FutureSharks/e-paper-art-display/artwork/003_jan-van-eyck_portrait-of-a-man-self-portrait.jpg

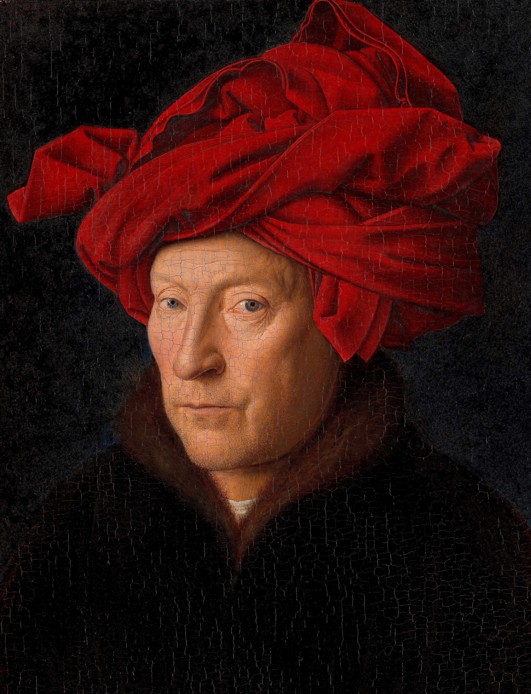
artwork/003_jan-van-eyck_portrait-of-a-man-self-portrait.jpg
