FutureSharks/e-paper-art-display/artwork/003_jan-van-eyck_portrait-of-a-man-self-portrait.preview.png

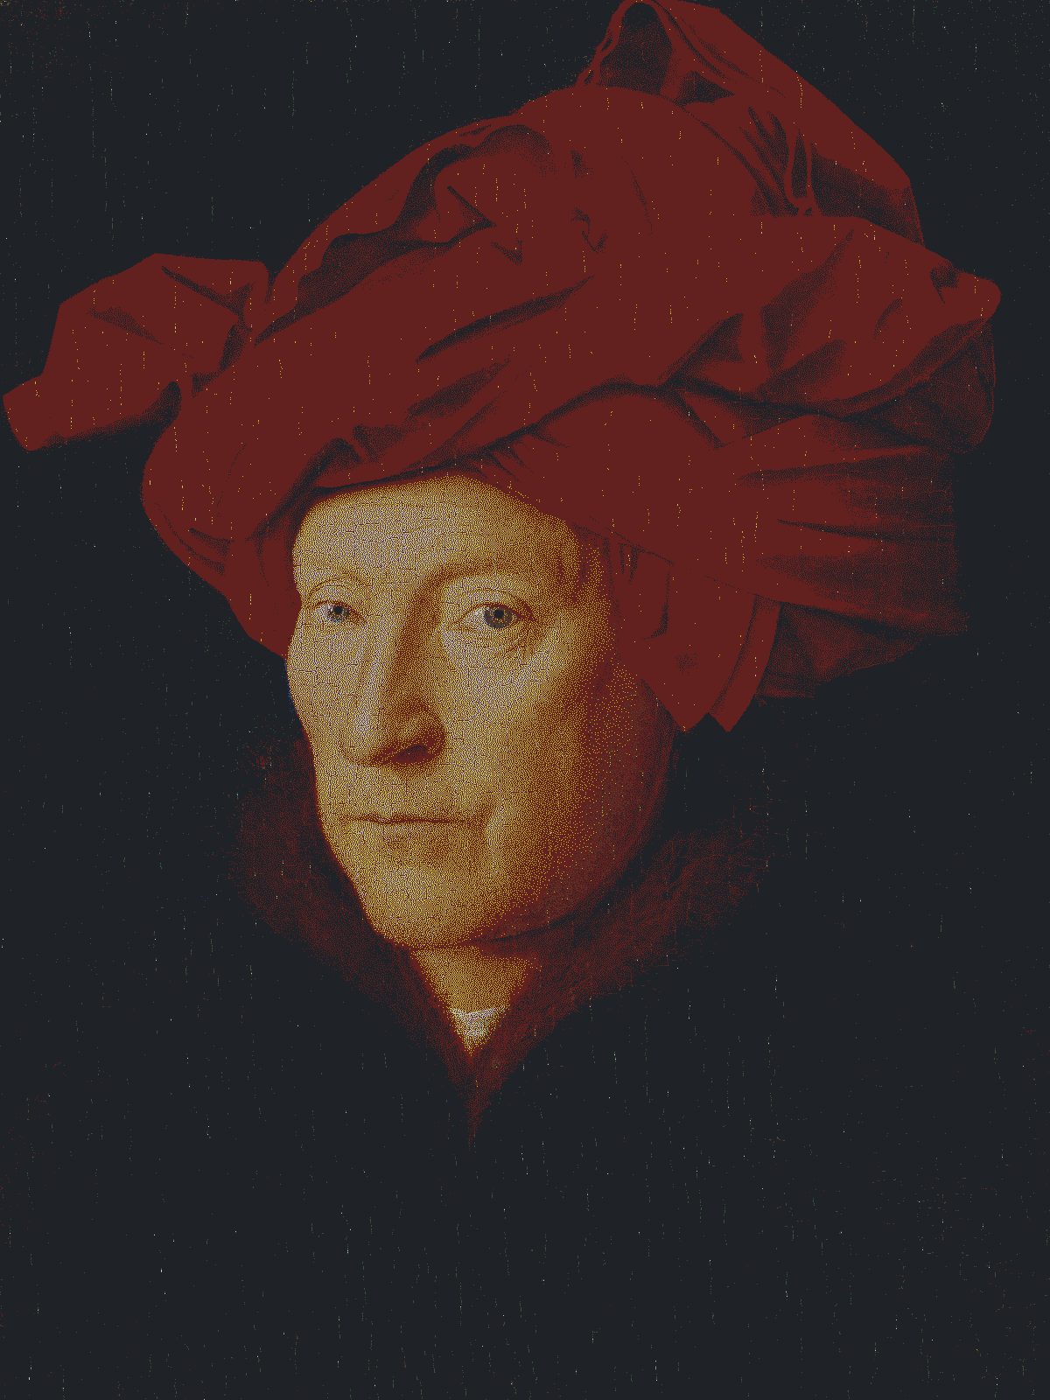
artwork/003_jan-van-eyck_portrait-of-a-man-self-portrait.preview.png
