FutureSharks/e-paper-art-display/artwork/004_johannes-vermeer_girl-with-a-pearl-earring.jpg

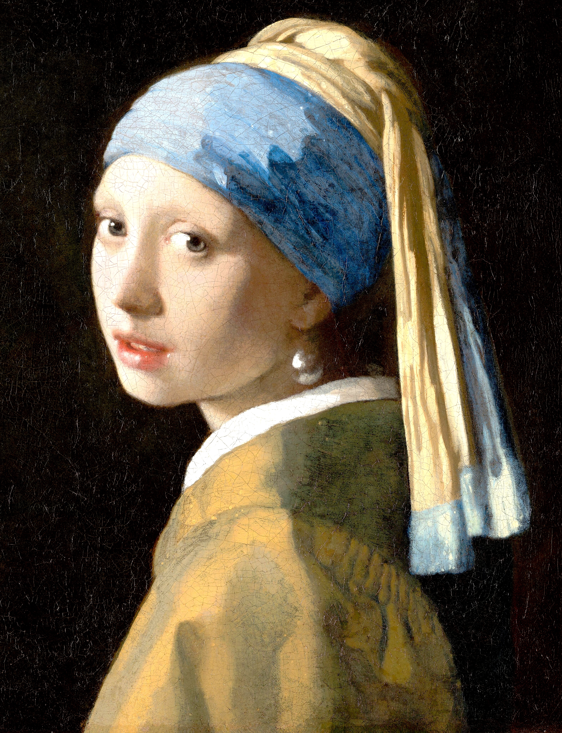
artwork/004_johannes-vermeer_girl-with-a-pearl-earring.jpg
