FutureSharks/e-paper-art-display/artwork/009_sandro-botticelli_idealized-portrait-of-a-lady-portrait-of-simonetta.preview.png

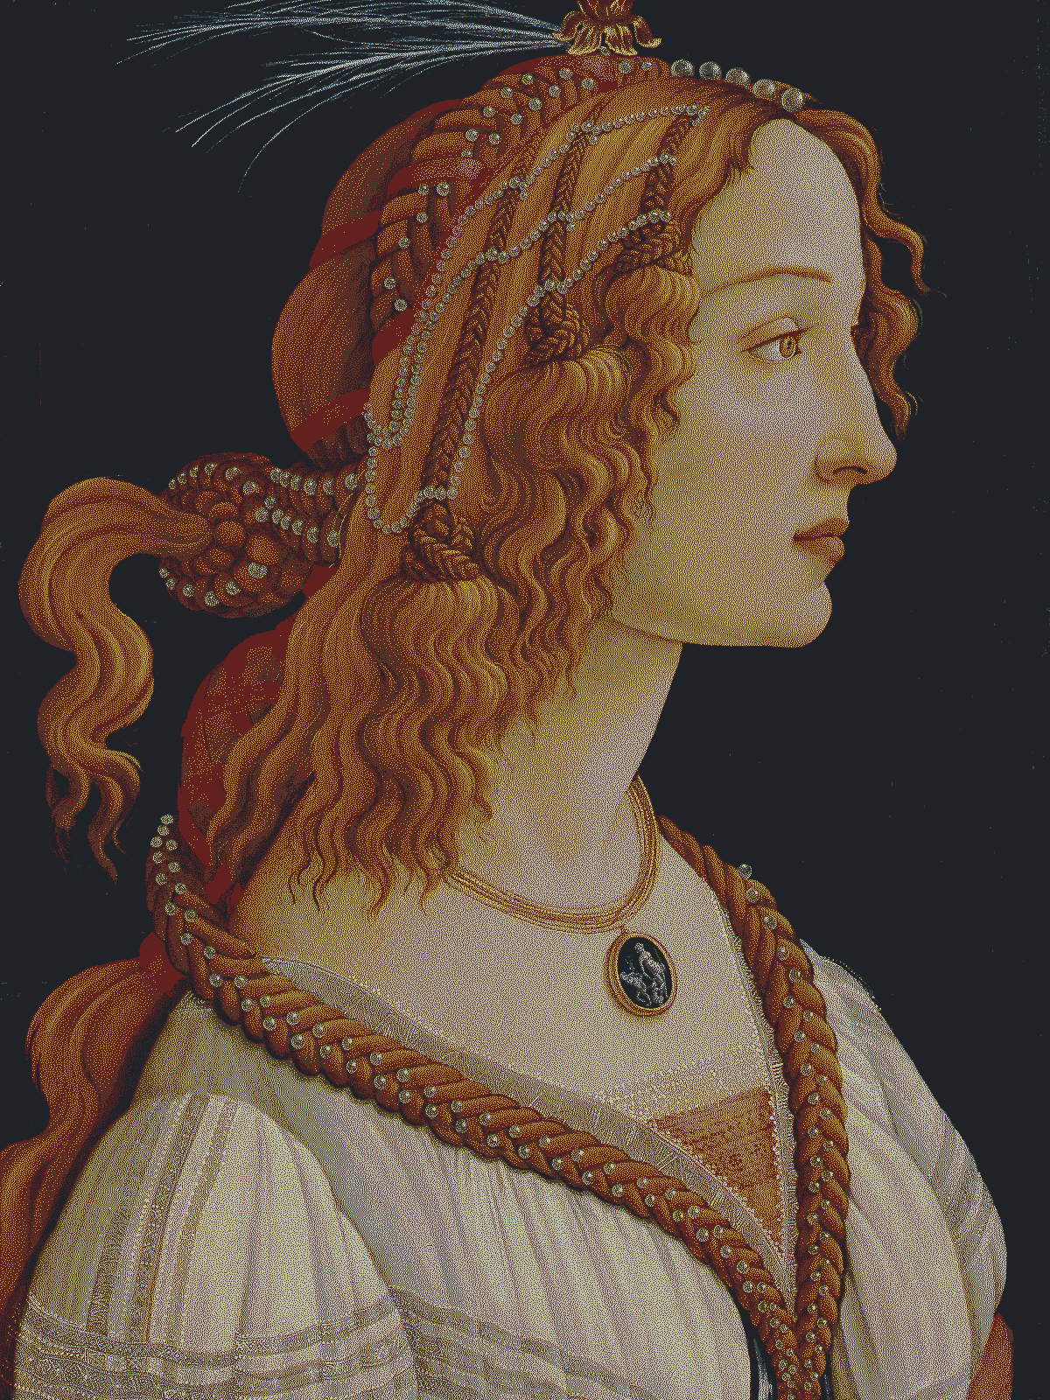
artwork/009_sandro-botticelli_idealized-portrait-of-a-lady-portrait-of-simonetta.preview.png
