FutureSharks/e-paper-art-display/artwork/013_alexej-von-jawlensky_lady-with-fan.jpg

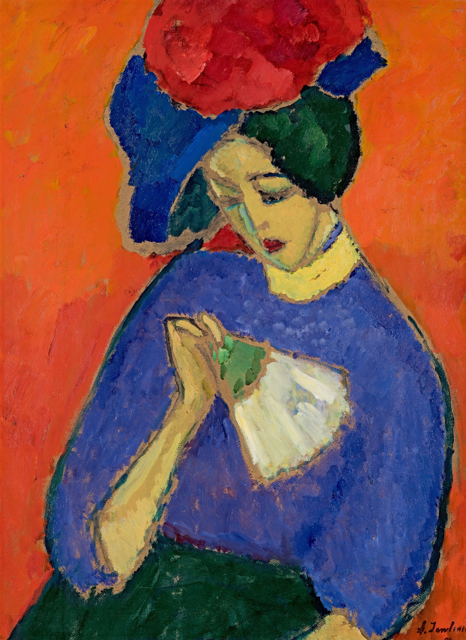
artwork/013_alexej-von-jawlensky_lady-with-fan.jpg
