FutureSharks/e-paper-art-display/artwork/013_alexej-von-jawlensky_lady-with-fan.preview.png

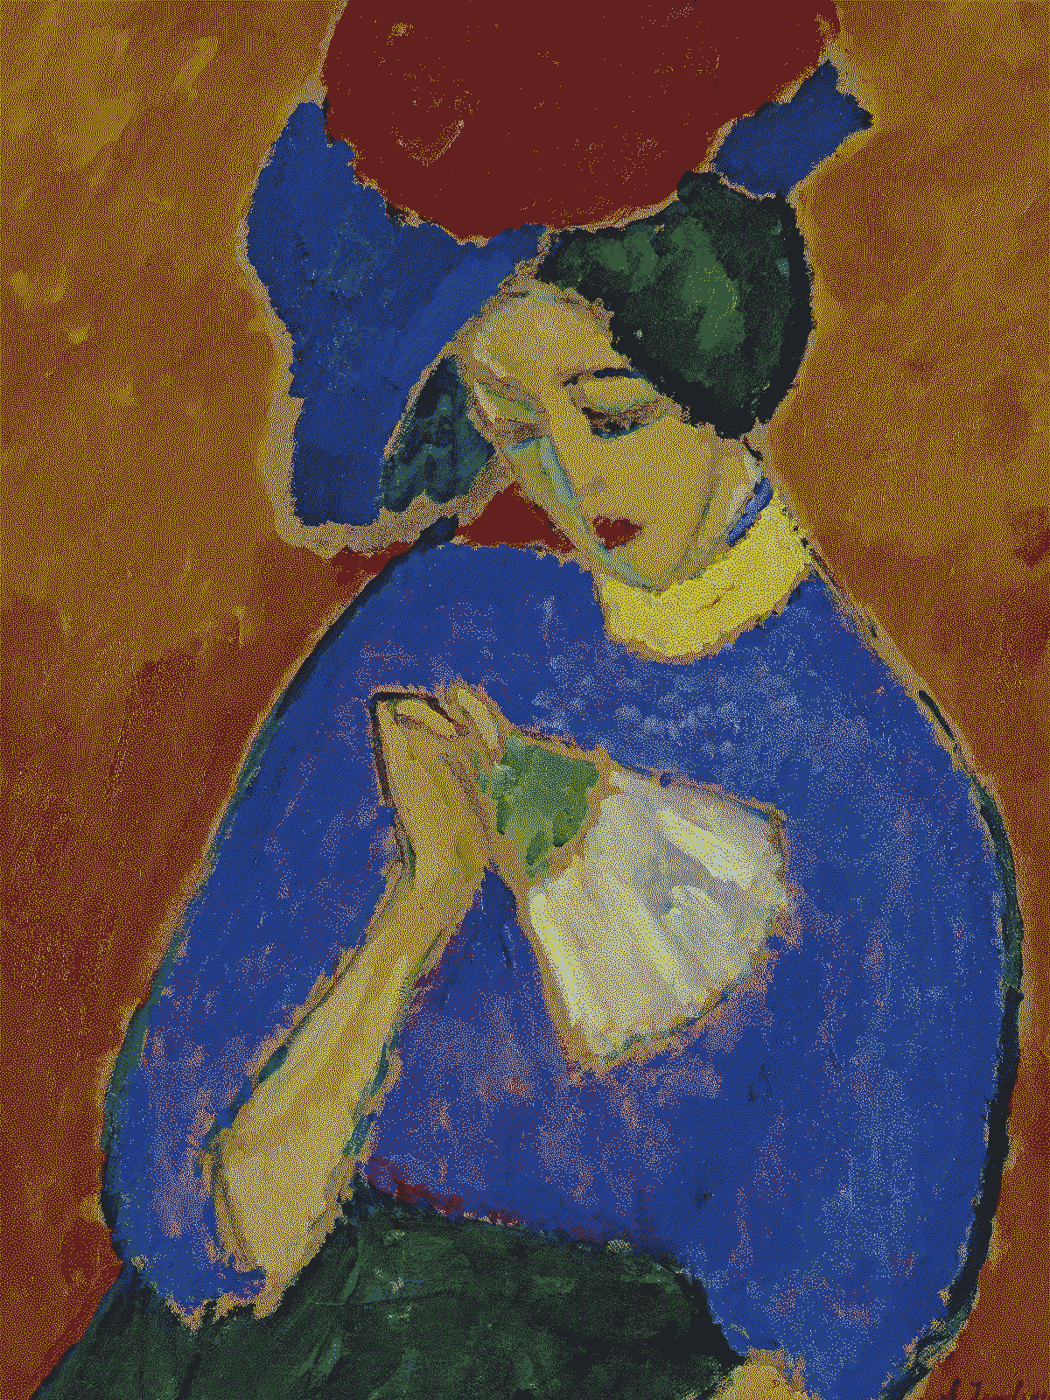
artwork/013_alexej-von-jawlensky_lady-with-fan.preview.png
