FutureSharks/e-paper-art-display/artwork/034_august-macke_woman-supporting-a-flower-bowl.jpg

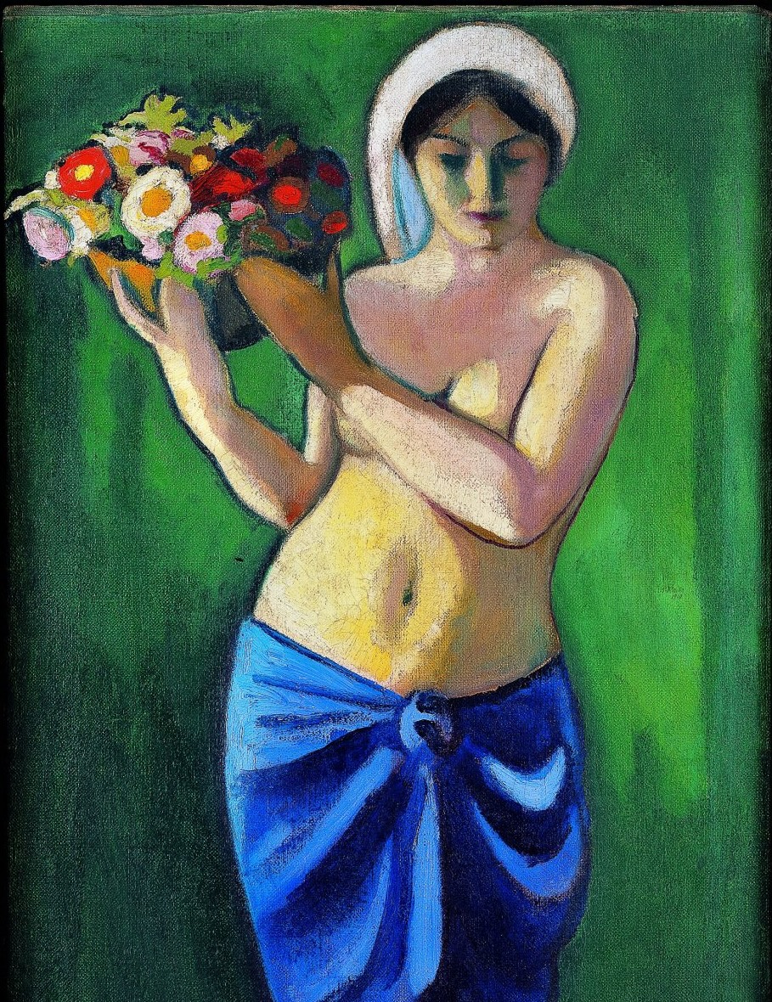
artwork/034_august-macke_woman-supporting-a-flower-bowl.jpg
