FutureSharks/e-paper-art-display/artwork/034_august-macke_woman-supporting-a-flower-bowl.preview.png

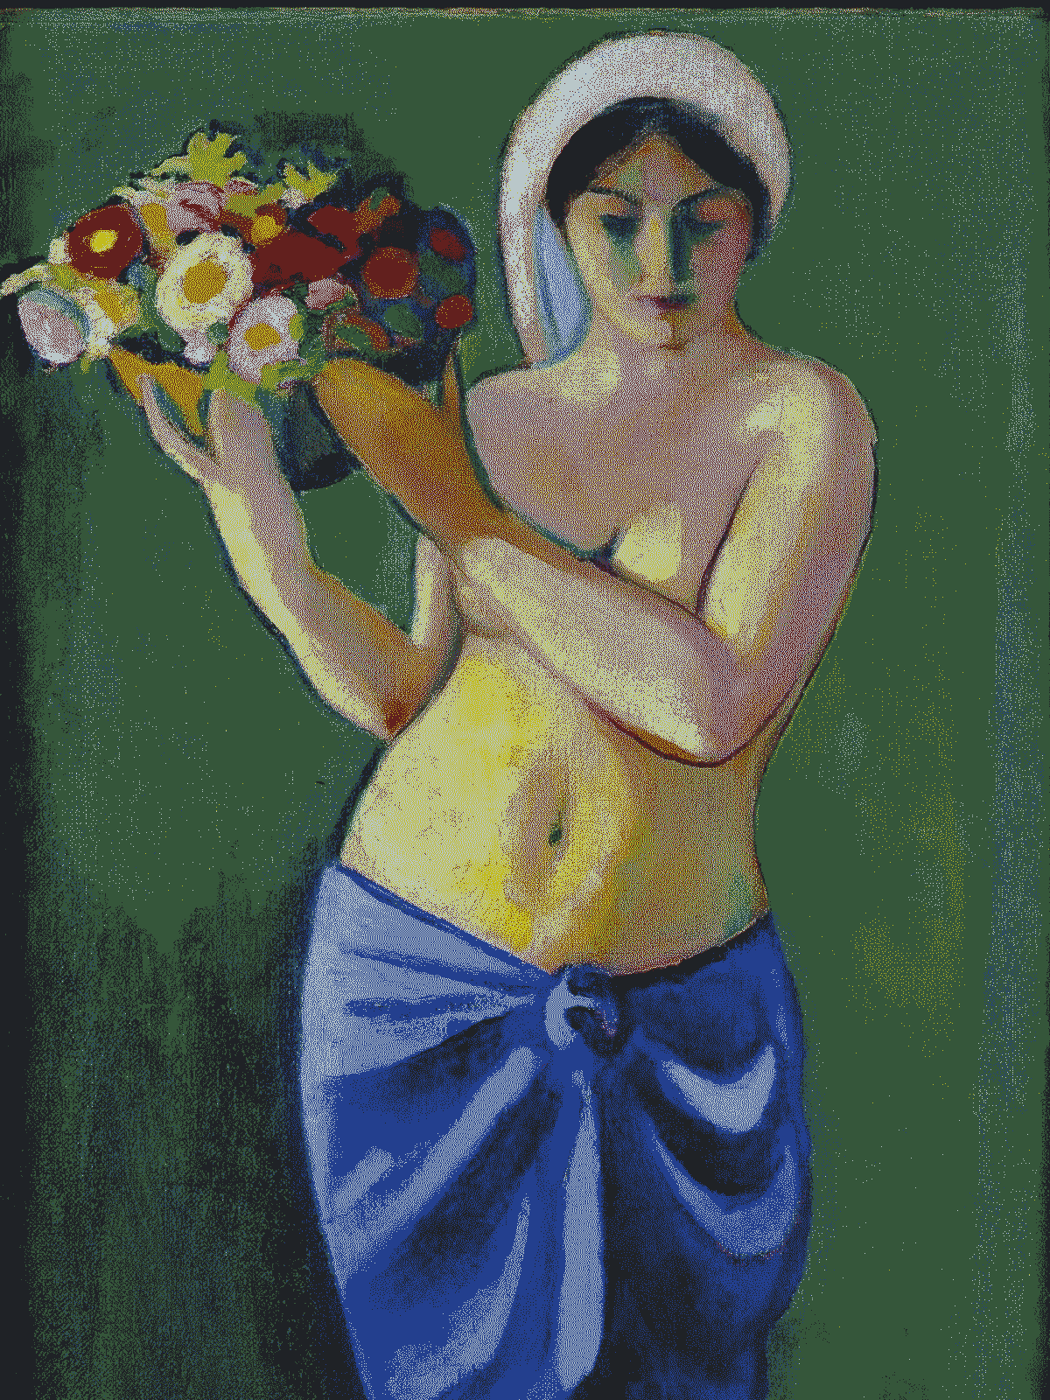
artwork/034_august-macke_woman-supporting-a-flower-bowl.preview.png
