FutureSharks/e-paper-art-display/artwork/036_edvard-munch_the-scream.jpg

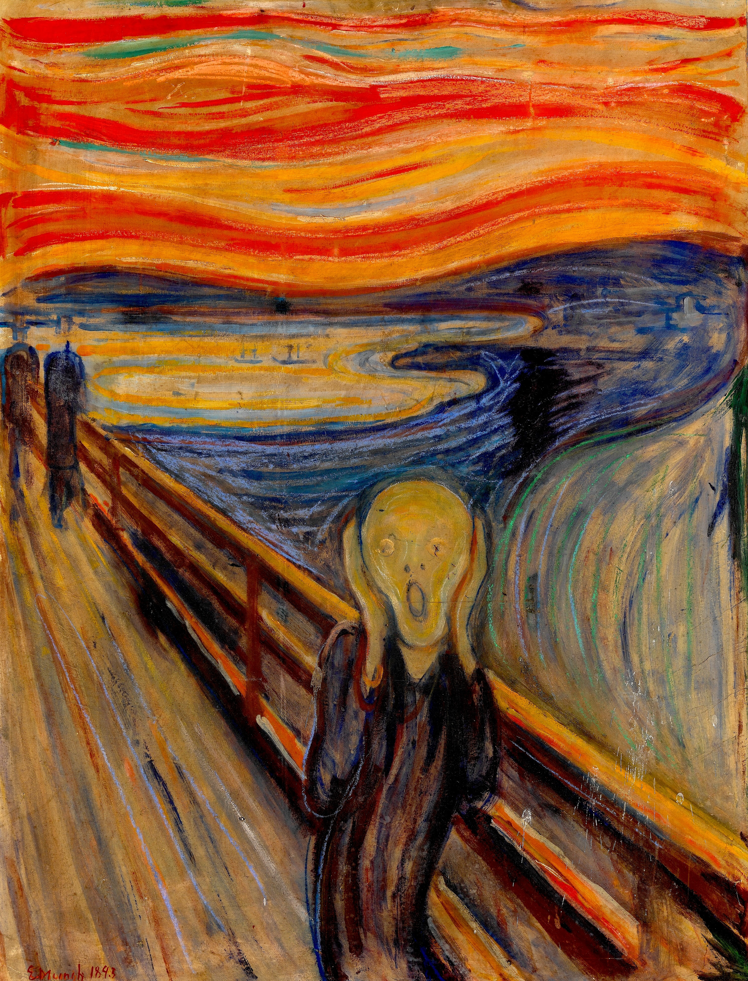
artwork/036_edvard-munch_the-scream.jpg
