FutureSharks/e-paper-art-display/artwork/036_edvard-munch_the-scream.preview.png

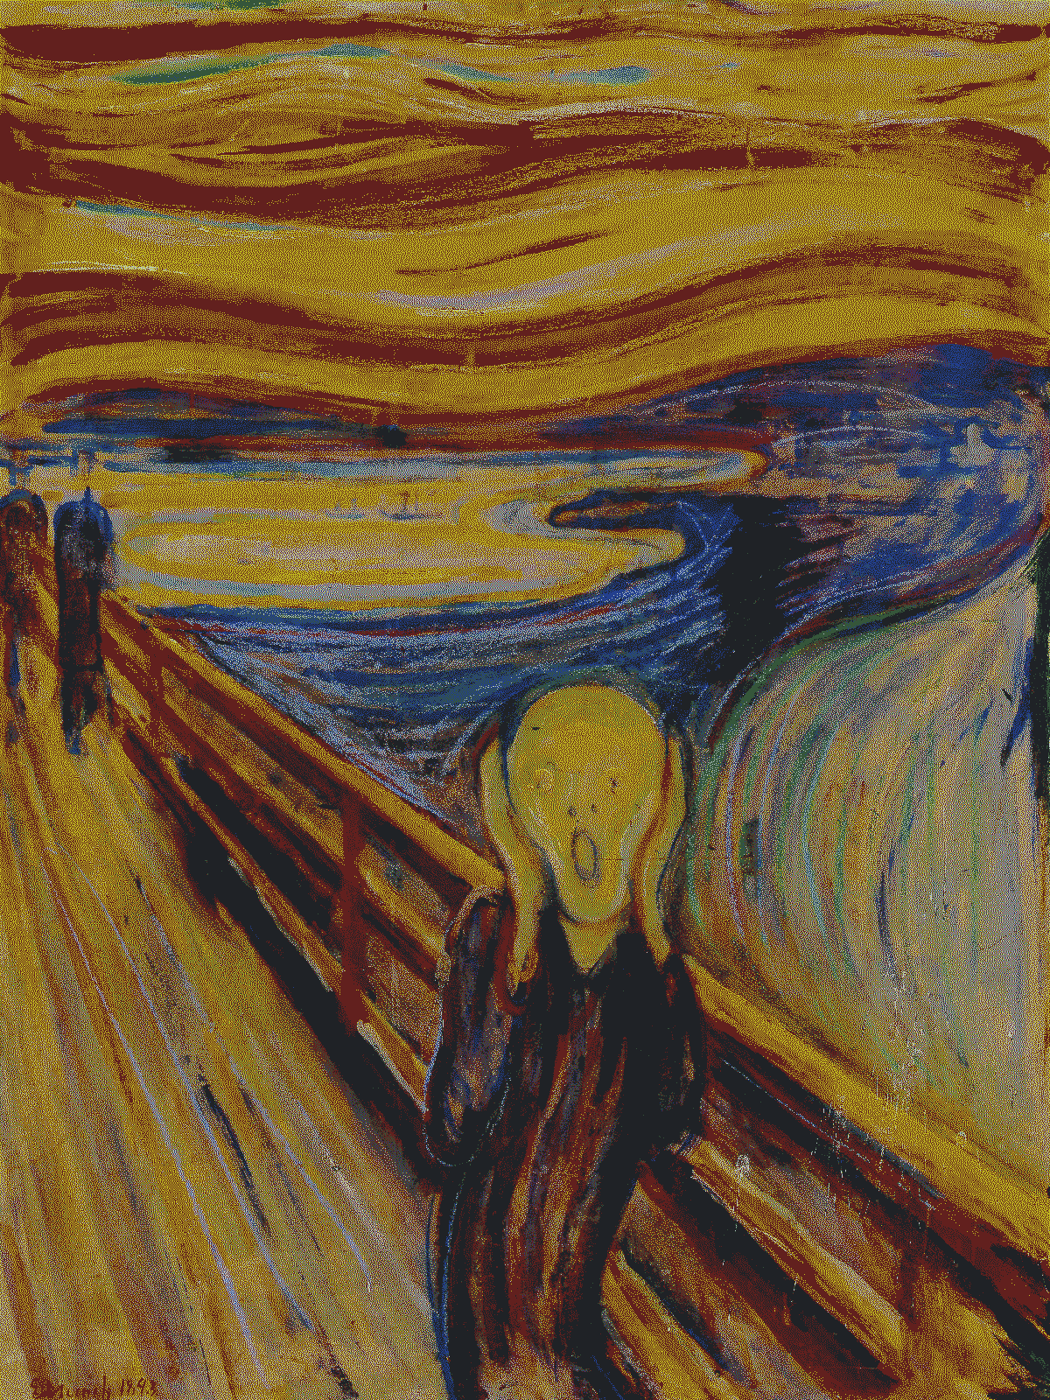
artwork/036_edvard-munch_the-scream.preview.png
