FutureSharks/e-paper-art-display/artwork/070_henri-matisse_blues-nudes.jpg

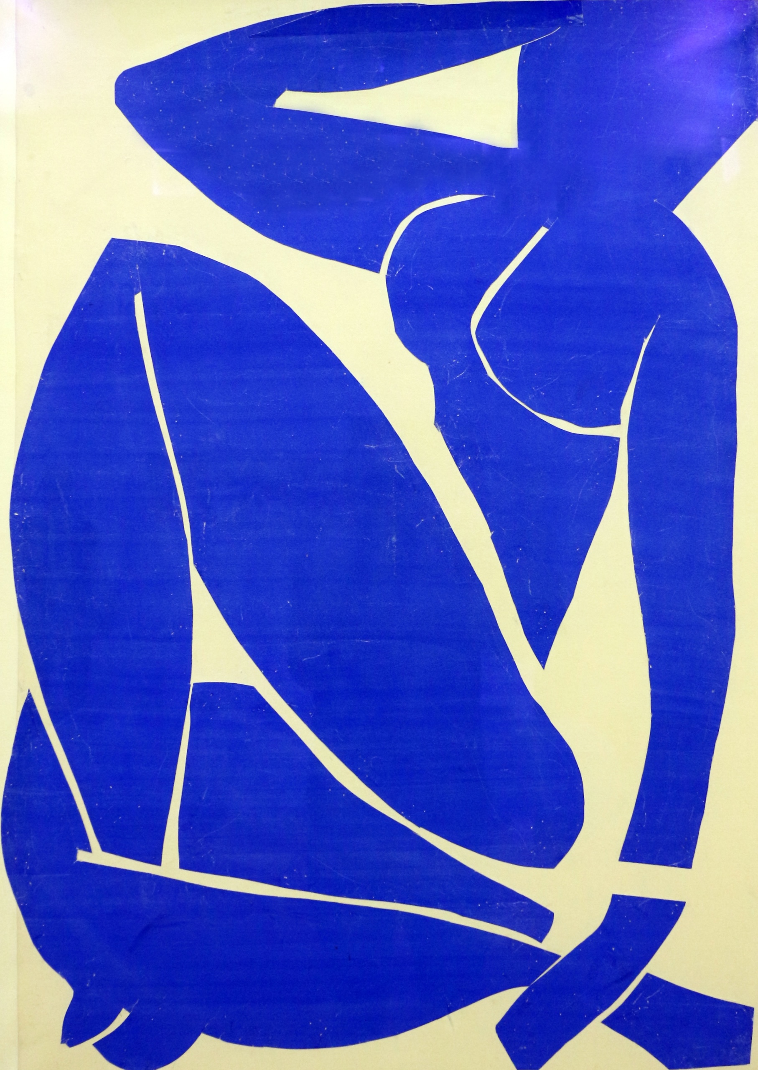
artwork/070_henri-matisse_blues-nudes.jpg
