FutureSharks/e-paper-art-display/artwork/070_henri-matisse_blues-nudes.preview.png

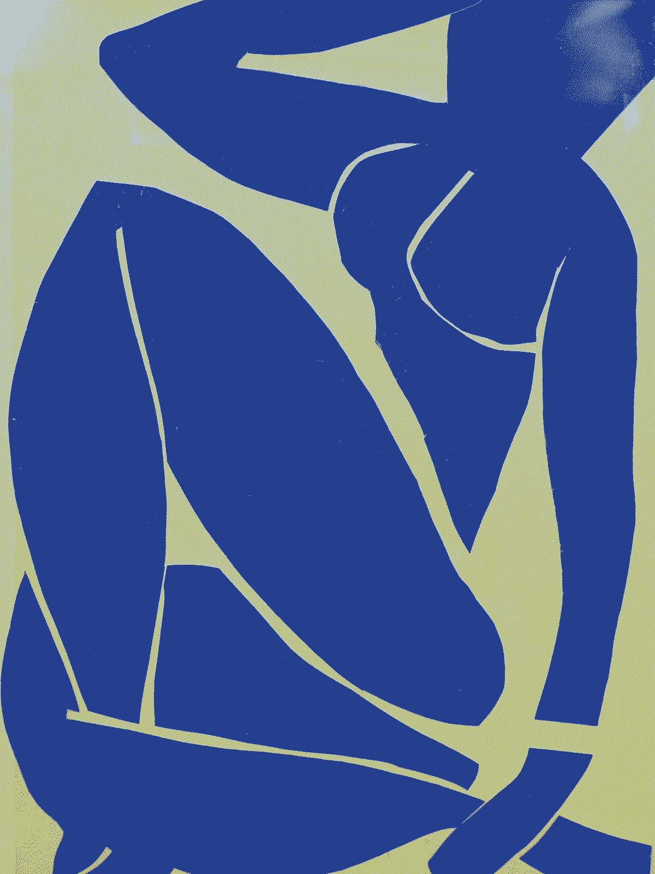
artwork/070_henri-matisse_blues-nudes.preview.png
