FutureSharks/e-paper-art-display/artwork/126_vincent-van-gogh_road-with-cypress-and-star.jpg

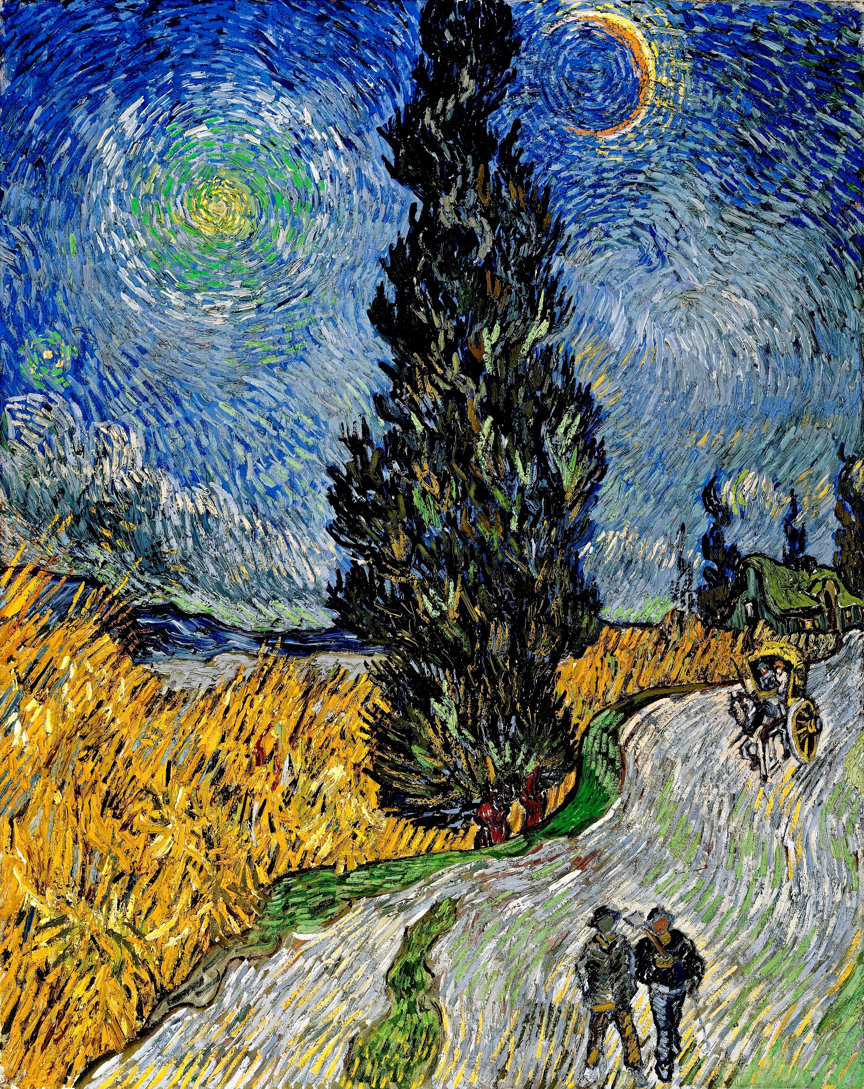
artwork/126_vincent-van-gogh_road-with-cypress-and-star.jpg
