FutureSharks/e-paper-art-display/artwork/53113.jpg

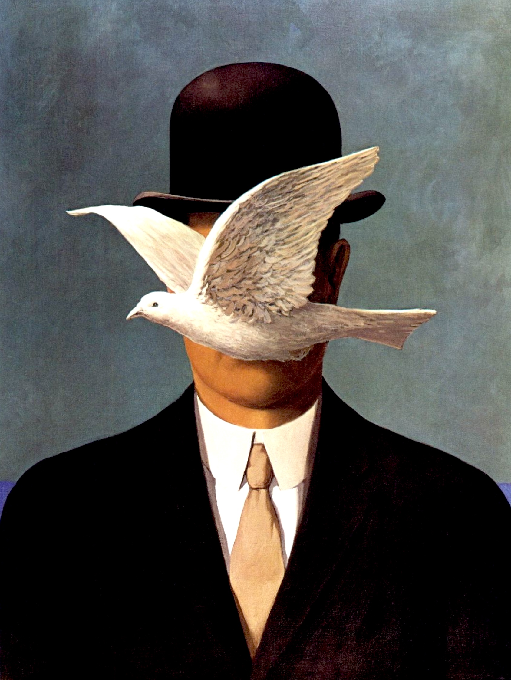
artwork/53113.jpg
