FutureSharks/e-paper-art-display/images/adafruit_products_schem.png

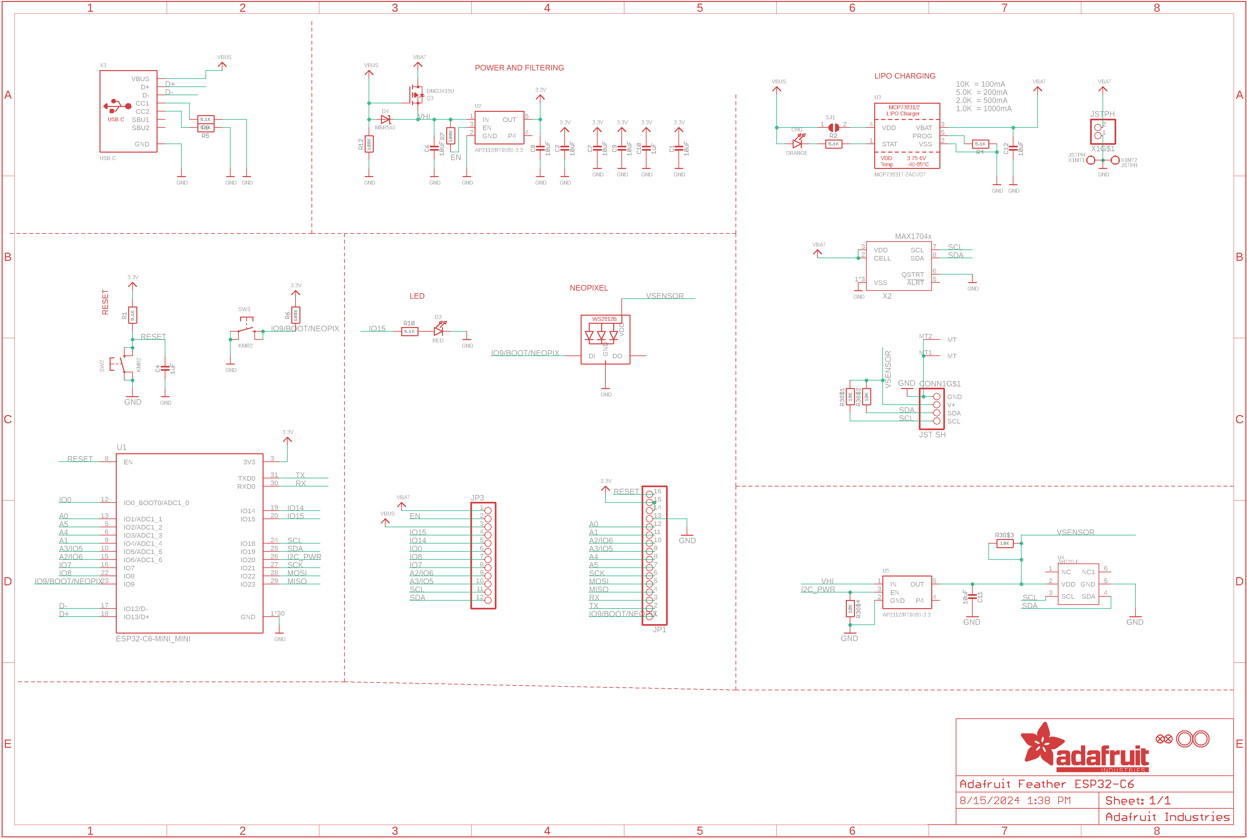
images/adafruit_products_schem.png
