FutureSharks/e-paper-art-display/images/IMG_2633.jpeg

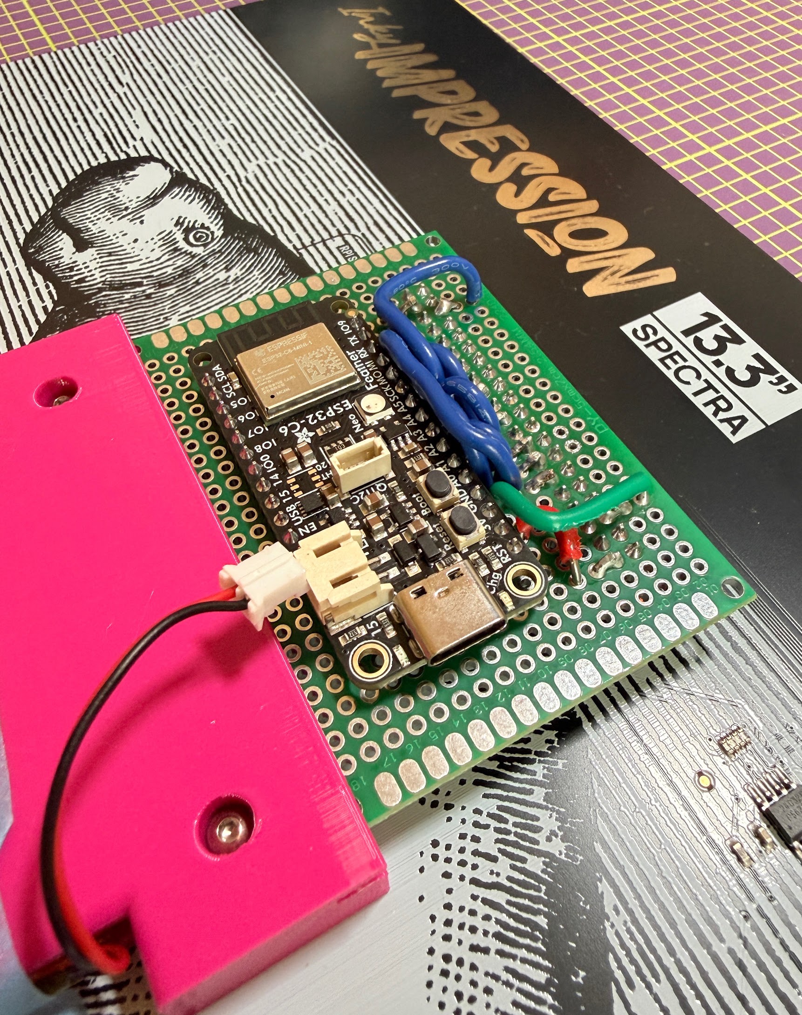
images/IMG_2633.jpeg
