FutureSharks/e-paper-art-display/images/IMG_2637.jpeg

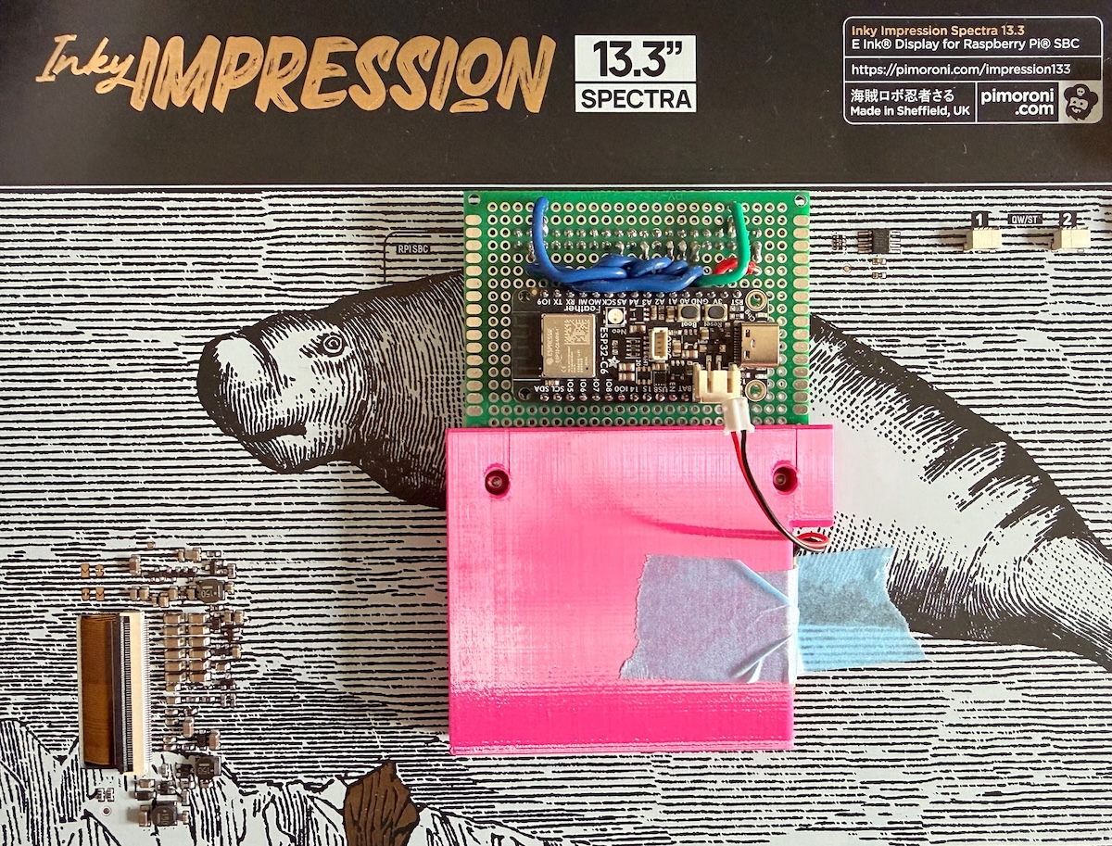
images/IMG_2637.jpeg
