FutureSharks/e-paper-art-display/src/status_line.cpp

#include "status_line.h"

#include <Arduino.h>
#include <ArduinoLog.h>
#include <time.h>

#include "config.h"
#include "fonts.h"
#include "text_box.h"

/* Padding between the text and the edge of its white box. */
static const int PAD_X = 8;
static const int PAD_Y = 4;

/* Append to `text` with a separator if something is already there. */
static void append(char *text, size_t len, const char *item)
{
  size_t used = strlen(text);
  snprintf(text + used, len - used, "%s%s", used > 0 ? "  |  " : "", item);
}

void status_line_begin(uint32_t position, uint32_t count, const char *name,
                       const BatteryStatus *battery)
{
  status_line_end();

  /* Room for every item, with a manifest name of up to 128 bytes. */
  char text[224] = "";
  char item[32];

#if SHOW_IMAGE_INDEX
  snprintf(item, sizeof(item), "Image %u/%u", (unsigned)position, (unsigned)count);
  append(text, sizeof(text), item);
#endif

#if SHOW_FILE_NAME
  append(text, sizeof(text), name);
#endif

#if SHOW_BATTERY_PERCENTAGE
  if (battery == nullptr)
    snprintf(item, sizeof(item), "Battery unknown");
  else if (!battery->present)
    snprintf(item, sizeof(item), "USB power");
  else
    snprintf(item, sizeof(item), "Battery %d%%", (int)(battery->percent + 0.5f));
  append(text, sizeof(text), item);
#endif

#if SHOW_REFRESH_TIME
  /* Local time, set by time_set() before anything is fetched. Taken now, a
   * few seconds before the stream starts and under a minute before the panel
   * finishes refreshing. */
  time_t now = time(nullptr);
  struct tm local;
  localtime_r(&now, &local);
  strftime(item, sizeof(item), "%d %b %H:%M", &local);
  append(text, sizeof(text), item);
#endif

  if (text[0] == '\0')
    return;

  if (text_box_begin(&FONT_SMALL, nullptr, PAD_X, PAD_Y, text))
    Log.notice("Status line: \"%s\"" CR, text);
}

void status_line_end()
{
  text_box_end();
}
