FutureSharks/e-paper-art-display/src/setup_wifi.cpp

#include <ArduinoLog.h>
#include <WiFi.h>

#include "secrets.h"
#include "setup_wifi.h"

// Give up associating after this long.
static const uint32_t WIFI_TIMEOUT_MS = 30000;

bool wifi_connect()
{
  Log.notice("Connecting to WiFi: %s" CR, WIFI_SSID);

  WiFi.mode(WIFI_STA);
  WiFi.begin(WIFI_SSID, WIFI_PASSWORD);

  unsigned long start = millis();
  while (WiFi.status() != WL_CONNECTED && (millis() - start) < WIFI_TIMEOUT_MS)
  {
    delay(500);
    Log.trace("." CR);
  }

  if (WiFi.status() != WL_CONNECTED)
  {
    Log.error("WiFi connection failed after %d ms" CR, (int)(millis() - start));
    return false;
  }

  Log.notice("Connected in %d ms, IP: %s, RSSI: %d dBm" CR, (int)(millis() - start),
             WiFi.localIP().toString().c_str(), (int)WiFi.RSSI());
  return true;
}

// Tear down WiFi between attempts so the next wifi_connect() starts clean, and
// before the refresh - the radio is the expensive part of the wake cycle.
void wifi_reset()
{
  WiFi.disconnect(true);
  WiFi.mode(WIFI_OFF);
  delay(500);
}
